masonmcg/HeatShield-Biometrics-Prototype/README.md

# HeatShield-Biometrics-Prototype

HeatShield Biometrics Prototype files

Adafruit ESP32-S2 Reverse TFT Feather microcontroller
