masonmcg/HeatShield-Biometrics-Prototype/MAIN/Prototype_001_Schematic/PrototypePinout.xlsx

Peripheral | ESP32 | Notes
LoRa chip | ESP32 | Notes
3.3v | 3.3V | Vin – self explanatory
GND | GND
MISO | MISO
MOSI | MOSI
SCK | SCK
NSS | D5 | CS
RESET | D6 | active low
G0 | D9 | 5 digital I/O pins, software configured
Heart Rate (optical) | ESP32 | Notes
Vin | 3.3V | 1.8V - 5V
GND | GND
SCL | SCL
SDA | SDA
INT | D9 | interrupt – active low
RD | GND | RD LED grounding – maybe no connect
IRD | GND | IR LED grounding – maybe no connect
3-bit pad |  | I2C voltage level
Heart Rate (ECG) | ESP32 | Notes
3.3v | 3.3V | Vin – self explanatory
GND | GND
OUTPUT |  | analog??
LO+ |  | digital??
LO- |  | digital??
SDN |  | shutdown – active low to shutdown
Temperature - uses I2C | ESP32 | Notes
Vdd | 3.3V | 2.7-5.5V
Gnd | GND
SCL | SCL | already pull-up resistor on board
SDA | SDA | already pull-up resistor on board
Alert |  | over temp alert, open-drain, use pull-up resistor
A0 | GND | lower 3 bits of I2C address
A1 | GND | lower 3 bits of I2C address
A2 | GND | lower 3 bits of I2C address
Vibration Motor | ESP32 | Notes
Vin | VBAT | 2 - 5V, 100mA at 5V, 40mA at 2V
GND | GND
Control (NPN) | D10 | connect to npn transistor
Temperature - uses I2C | ESP32 | Notes
V+ | 3.3V | 1.4V - 5.5V
GND | GND
SCL | SCL | open-drain, use pull-up resistor
SDA | SDA | open-drain, use pull-up resistor
ALERT |  | over temp alert, open-drain, use pull-up resistor
ADD0 |  | address select, connect to V+, GND, SCL or SDA
