masonmcg/HeatShield-Biometrics-Prototype/DATASHEETS/HeartRate_Optical_MAX30102_datasheet.PNG

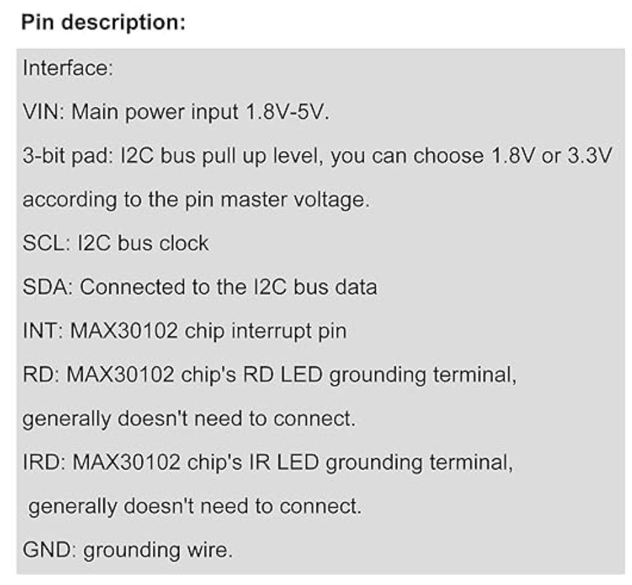
DATASHEETS/HeartRate_Optical_MAX30102_datasheet.PNG
