masonmcg/HeatShield-Biometrics-Prototype/PARTS/Sensors.docx

Heart Rate:

- Optical: https://www.amazon.com/Sensor-Module-MAX30102-Detection-Compatible/dp/B094JC48HQ
  - Price: 9.99
  - Quantity: 1 (2-pack)
- ECG: https://www.ebay.com/itm/203859866393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
  - Price: 10.14
  - Quantity: 2
- ECG Pads: https://www.amazon.com/3M-2238-Electrode-Cloth-Adult-Part/dp/B00F4JHEGU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
  - Price: 16.49
  - Quantity: 1 (50-pack)

Temperature:

- https://www.digikey.com/en/products/detail/umw/TMP112AIDRLR/16705906
  - Price: 1.16
  - Quantity: 5
