masonmcg/HeatShield-Biometrics-Prototype/PARTS/PartsList1.png

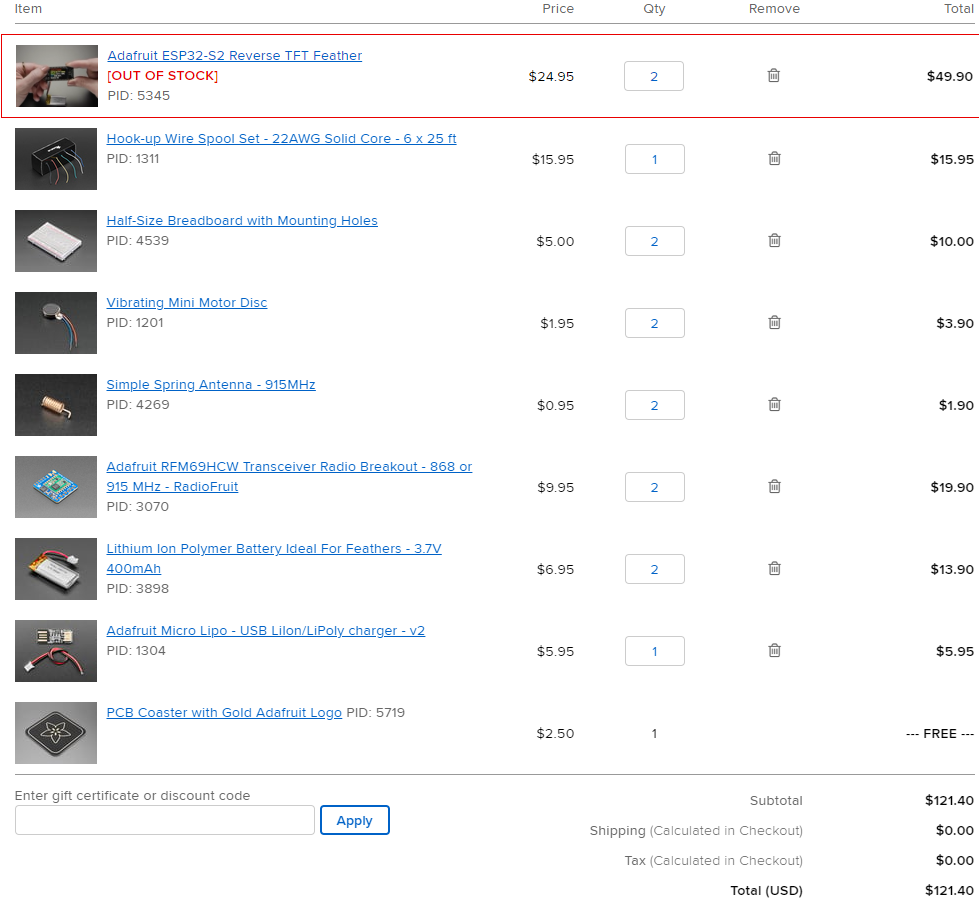
PARTS/PartsList1.png
