masonmcg/HeatShield-Biometrics-Prototype/CAD/PROTOTYPE_01/ASSEM_01.SLDASM

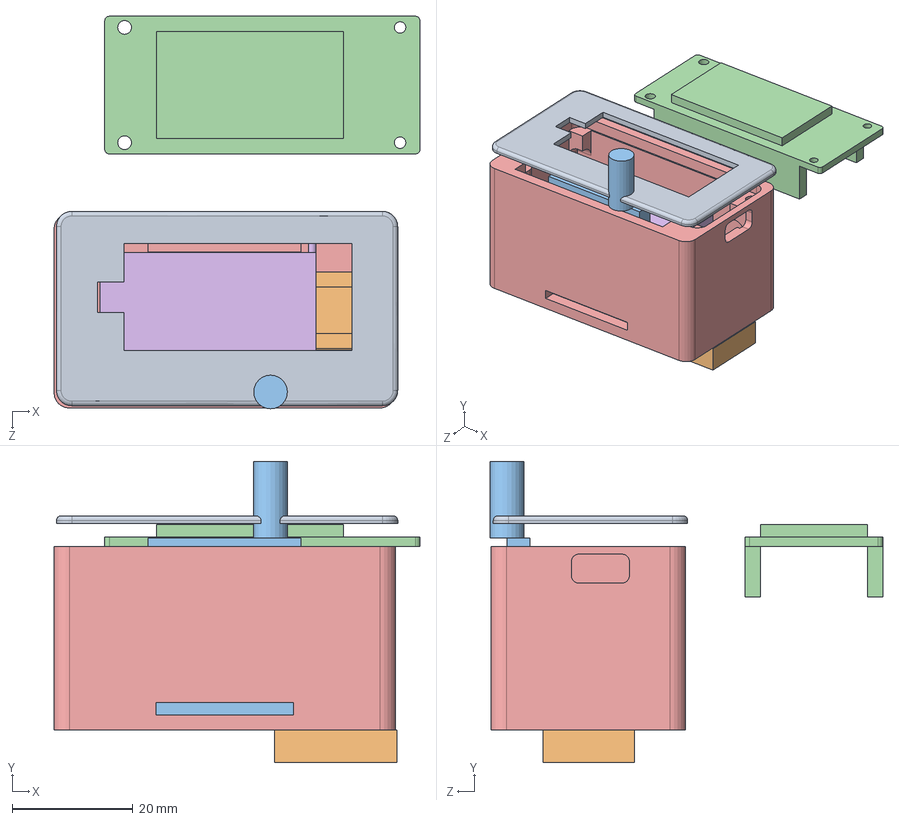
[picture p3: CAD file, 2024-04-25]
CAD/PROTOTYPE_01/ASSEM_01.SLDASM
60.7 x 50.0 x 65.2 mm
BATTERY
CASING
ESP32
LORA
OPT_HR
COVER
