masonmcg/HeatShield-Biometrics-Prototype/CAD/PROTOTYPE_01/CASING_SEALED.SLDPRT

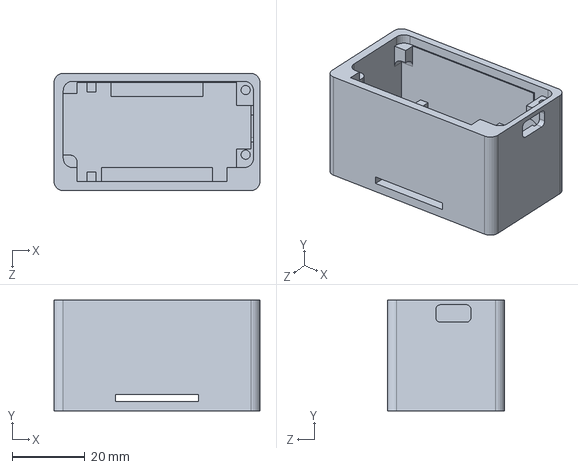
[picture p4: CAD file, 2024-04-27]
CAD/PROTOTYPE_01/CASING_SEALED.SLDPRT
56.6 x 30.5 x 32.3 mm
