masonmcg/HeatShield-Biometrics-Prototype/CAD/PROTOTYPE_01/COVER.SLDPRT

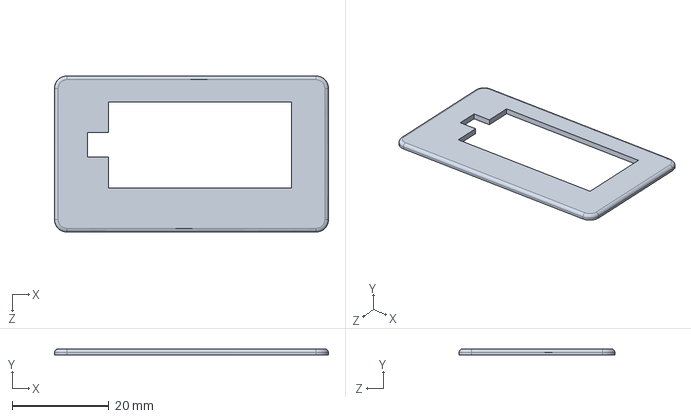
[picture p5: CAD file, 2024-04-27]
CAD/PROTOTYPE_01/COVER.SLDPRT
56.6 x 1.27 x 32.3 mm
