masonmcg/HeatShield-Biometrics-Prototype/CAD/PROTOTYPE_01/COVER_BUTTON.SLDPRT

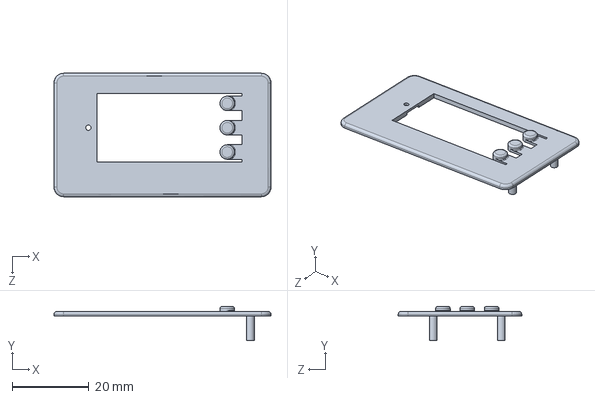
[picture p6: CAD file, 2024-04-26]
CAD/PROTOTYPE_01/COVER_BUTTON.SLDPRT
56.6 x 8.89 x 32.3 mm
