masonmcg/HeatShield-Biometrics-Prototype/CAD/PROTOTYPE_01/OPT_HR.SLDPRT

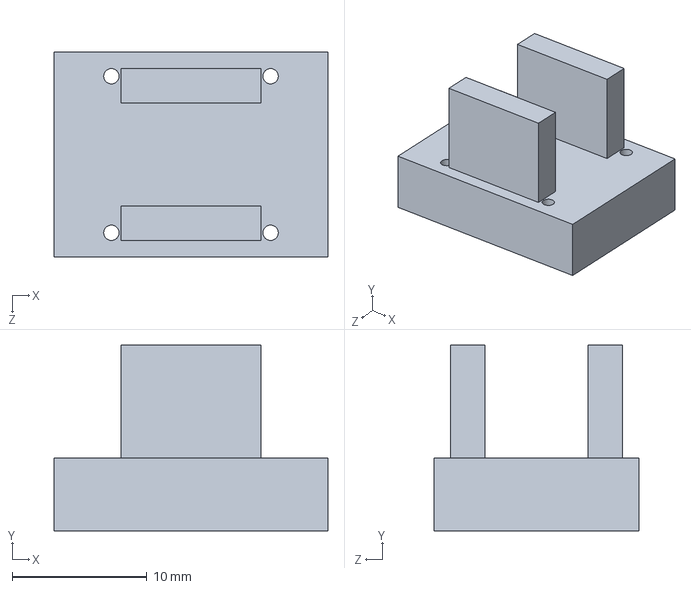
[picture p7: CAD file, 2024-04-23]
CAD/PROTOTYPE_01/OPT_HR.SLDPRT
20.3 x 13.8 x 15.2 mm
