masonmcg/HeatShield-Biometrics-Prototype/CAD/PROTOTYPE_01/ESP32.SLDPRT

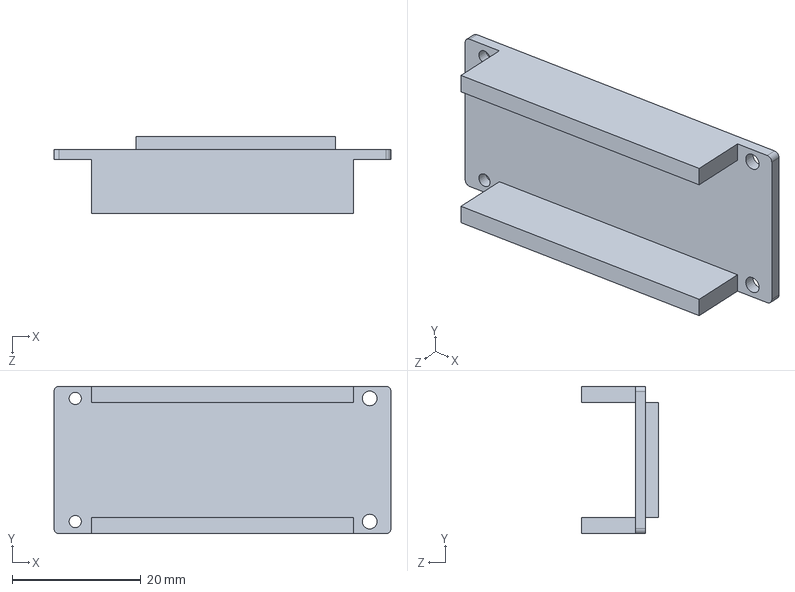
[picture p8: CAD file, 2024-04-23]
CAD/PROTOTYPE_01/ESP32.SLDPRT
52.3 x 22.9 x 12.0 mm
