masonmcg/HeatShield-Biometrics-Prototype/CAD/PROTOTYPE_01/BATTERY.SLDPRT

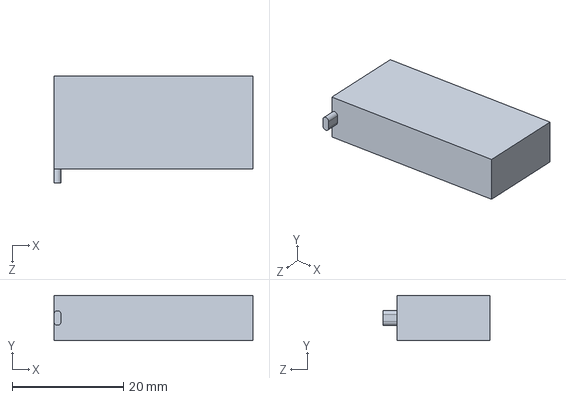
[picture p9: CAD file, 2024-04-23]
CAD/PROTOTYPE_01/BATTERY.SLDPRT
35.8 x 8.13 x 19.3 mm
