masonmcg/HeatShield-Biometrics-Prototype/CAD/PROTOTYPE_01/LORA.SLDPRT

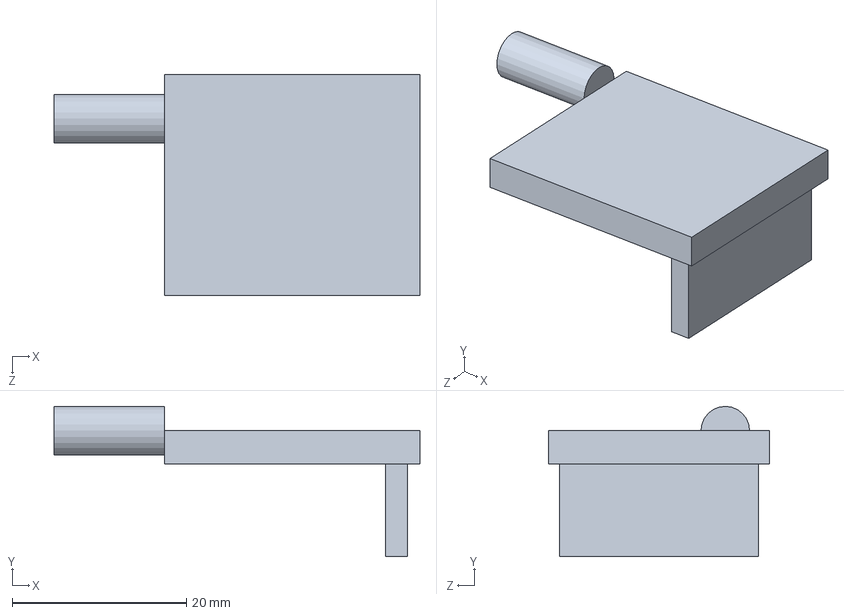
[picture p10: CAD file, 2024-04-23]
CAD/PROTOTYPE_01/LORA.SLDPRT
42.1 x 17.3 x 25.4 mm
