masonmcg/HeatShield-Biometrics-Prototype/CAD/PROTOTYPE_01/STL/COVER_STL_V05.STL

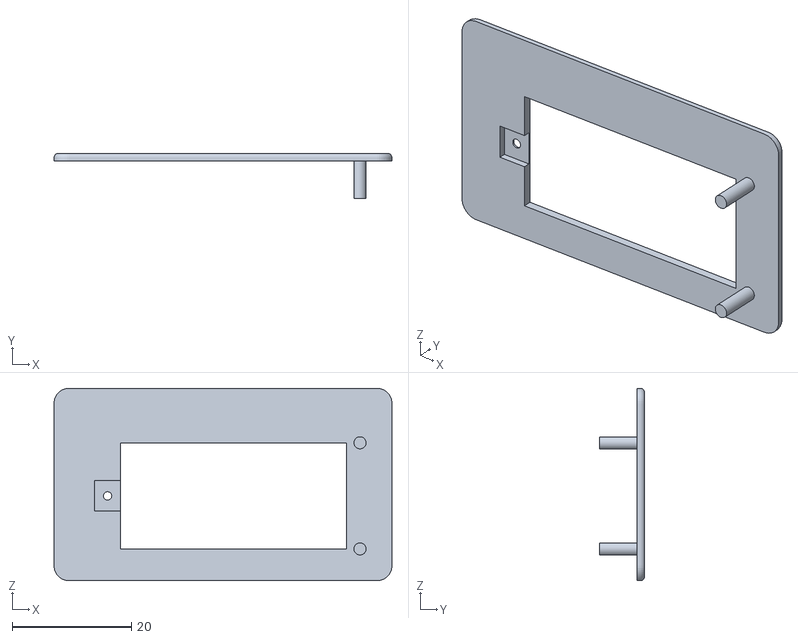
[picture p11: CAD file, 2024-04-26, an earlier design]
CAD/PROTOTYPE_01/STL/COVER_STL_V05.STL
56.6 x 7.62 x 32.3
