masonmcg/HeatShield-Biometrics-Prototype/CAD/PROTOTYPE_01/STL/CASING_STL_V05.STL

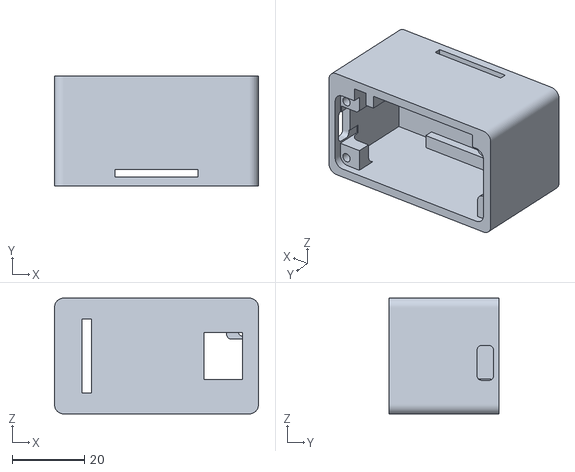
[picture p12: CAD file, 2024-04-26, an earlier design]
CAD/PROTOTYPE_01/STL/CASING_STL_V05.STL
56.4 x 30.5 x 32.0
