masonmcg/HeatShield-Biometrics-Prototype/CAD/PROTOTYPE_01/STL/COVER_STL_V04.STL

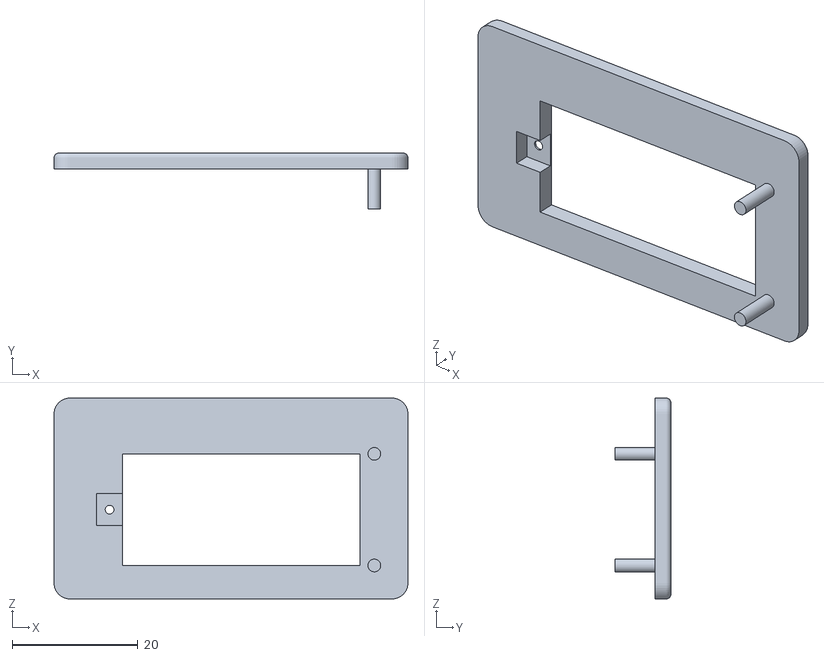
[picture p13: CAD file, 2024-04-26, an earlier design]
CAD/PROTOTYPE_01/STL/COVER_STL_V04.STL
56.4 x 8.89 x 32.0
