masonmcg/HeatShield-Biometrics-Prototype/(list of files, cad)

Other CAD files:
CAD/PROTOTYPE_01/STL/CASING_SEALED_V01.STL
CAD/PROTOTYPE_01/STL/COVER_STL_V06.STL
CAD/PROTOTYPE_01/CASING.SLDPRT
CAD/PROTOTYPE_01/STL/COVER_BUTTON_V01.STL
CAD/PROTOTYPE_01/STL/CASING_STL_V06.STL
CAD/PROTOTYPE_01/STL/CASING_STL_V04.STL
CAD/PROTOTYPE_01/STL/COVER_STL_V02.STL
CAD/PROTOTYPE_01/STL/CASING_STL_V01.STL
CAD/PROTOTYPE_01/STL/CASING_STL_V02.STL
CAD/PROTOTYPE_01/STL/CASING_STL_V03.STL
CAD/PROTOTYPE_01/STL/COVER_STL_V01.STL
