masonmcg/HeatShield-Biometrics-Prototype/MAIN/Prototype_001/haptic.h

const int hapticControl = 10; // D0 button pin

// function hapticInit
// sets up output pin for use
void hapticInit() {
  Serial.println("hapticInit start");
  pinMode(hapticControl, OUTPUT); // Initialize pin 10 as output
  digitalWrite(hapticControl, LOW); // Set pin 10 to low
  Serial.println("hapticInit complete");
}

// function hapticChirp
// chirps haptic feedback vibration motor
void hapticChirp() {
  digitalWrite(hapticControl, HIGH);
  delay(100);
  digitalWrite(hapticControl, LOW);
}
