masonmcg/HeatShield-Biometrics-Prototype/TESTING/ScreenPrintFunction/ScreenPrintFunction.ino

/**************************************************************************
  This is a library for several Adafruit displays based on ST77* drivers.

  Works with the Adafruit ESP32-S2 TFT Feather
    ----> http://www.adafruit.com/products/5300

  Check out the links above for our tutorials and wiring diagrams.

  Adafruit invests time and resources providing this open source code,
  please support Adafruit and open-source hardware by purchasing
  products from Adafruit!

  Written by Limor Fried/Ladyada for Adafruit Industries.
  MIT license, all text above must be included in any redistribution
 **************************************************************************/

#include <Adafruit_GFX.h>    // Core graphics library
#include <Adafruit_ST7789.h> // Hardware-specific library for ST7789
#include <SPI.h>

// Use dedicated hardware SPI pins
Adafruit_ST7789 tft = Adafruit_ST7789(TFT_CS, TFT_DC, TFT_RST);

void setup(void) {
  Serial.begin(9600);
  Serial.print(F("Hello! Feather TFT Test"));

  // turn on backlite
  pinMode(TFT_BACKLITE, OUTPUT);
  digitalWrite(TFT_BACKLITE, HIGH);

  // turn on the TFT / I2C power supply
  pinMode(TFT_I2C_POWER, OUTPUT);
  digitalWrite(TFT_I2C_POWER, HIGH);
  delay(10);

  // initialize TFT
  tft.init(135, 240); // Init ST7789 240x135
  tft.setRotation(3);
  tft.fillScreen(ST77XX_BLACK);

  Serial.println(F("Initialized"));
}

void loop() {
  // Call the function to print the message with the specified text
  printMessage("Hello, World!");

  // Delay to control the message update rate
  delay(2000);
}

// Function to print a message to the screen
void printMessage(const char* text) {
  // Clear the screen
  tft.fillScreen(ST77XX_BLACK);
  
  // Set text color, size, and position
  tft.setCursor(0, 30);
  tft.setTextColor(ST77XX_WHITE);
  tft.setTextSize(2);
  
  // Print the message
  tft.println(text);
}
