masonmcg/HeatShield-Biometrics-Prototype/(commit log)

2024-02-13 Added test for BMS
2024-02-13 First push on prototype!
2024-02-27 LORA Testing working. Added printing message to screen function
2024-04-16 Update README
    Specified initial prototype requirements
2024-04-18 added pinout file
    [PrototypePinout.xlsx]
2024-04-18 added battery.h
2024-04-23 First cad model
    [ASSEM_01.SLDASM, BATTERY.SLDPRT, CASING.SLDPRT, CASING_STL_V01_4_22_24.STL, ESP32.SLDPRT, LORA.SLDPRT, OPT_HR.SLDPRT]
2024-04-23 add filet
    [CASING.SLDPRT, CASING_STL_V01_4_22_24.STL]
2024-04-24 New casing cad
    [CASING.SLDPRT, CASING_STL_V02_4_24_24.STL]
2024-04-25 updated with new temp sensor
    [PrototypePinout.xlsx]
2024-04-25 minor update
    [PrototypePinout.xlsx]
2024-04-25 added temperature sensor code and other header files
2024-04-25 new cad
    [ASSEM_01.SLDASM, CASING.SLDPRT, CASING_STL_V03_4_24_24.STL, COVER.SLDPRT, COVER_STL_V01_4_24_24.STL]
2024-04-25 added buttons and stuff
2024-04-26 added haptic feedback vibration motor
    [PrototypePinout.xlsx]
2024-04-26 new rev of cad
    [CASING.SLDPRT, CASING_STL_V05_4_26_24.STL, COVER.SLDPRT, COVER_STL_V04_4_26_24.STL]
2024-04-26 cad rev
    [CASING.SLDPRT, CASING_STL_V06_4_26_24.STL, COVER.SLDPRT, COVER_BUTTON.SLDPRT, COVER_BUTTON_V01_4_26_24.STL, COVER_STL_V05_4_26_24.STL]
2024-04-27 added power on/off and some display stuff
2024-04-27 added hella code shit and im fuckin tired
    [PrototypePinout.xlsx]
2024-05-14 Added data logger python stuff and test arduino file
2024-05-15 added a bit to kaleb probe code
2024-05-15 added probe test stuff to main
2024-05-16 added battery percentage to lora testing files
